gustavgaston/ggsmdriver/README.md

# GGSMDriver

A small, reusable stepper driver module: STM32G0B1 + TMC2209, one 9–24 V supply
and a 4-wire motor on one row of screw terminals along one edge, and USB-C for serial
and firmware upload. The board is 4 layers, 55×45 mm, with every
part on top, for JLCPCB assembly.

## Layout

| Path | What |
|---|---|
| `requirements.md` | Circuit spec, pin map, parts with LCSC numbers, confirmed decisions |
| `PLAN.md` | Milestones |
| `HANDOFF.md` | Current state and how to regenerate everything (start here when resuming) |
| `hardware/ggsmdriver.py` | The design as Python: parts, pin→net map, PCB placement |
| `hardware/ggsmdriver.kicad_sym` | Custom TMC2209 symbol |
| `kicad/` | Generated KiCad project (schematic, PCB, PDF) and `reports/` |
| `kicad/fab/` | JLCPCB gerbers zip, BOM and placement (CPL) files |
| `firmware/` | STM32 HAL firmware: ggstepper core + Automato over USB serial (see its README) |

The KiCad files are generated by [autopcb](https://github.com/gustavgaston/autopcb)
from `hardware/ggsmdriver.py`; hand edits in KiCad are lost on regeneration.
They are KiCad 7 format and open in KiCad 10.

## Status

- Schematic: done (ERC clean in KiCad 10).
- PCB: generated and fully routed as a practice run; routing, placement and
  silkscreen to be reworked later.
- Fab files: generated.
- Firmware: ported and building; untested on hardware.
