gustavgaston/ggsmdriver/requirements.md

# GGSMDriver — requirements and circuit spec

Milestone 1, 2026-10-16. All confirmed by Gustav.

## Confirmed decisions

| Topic | Decision |
|---|---|
| MCU | STM32G0B1CBT6 (LQFP48) |
| Supply | 9–24 V DC on a 2-pole terminal next to the motor terminal (barrel jack dropped 2026-10-19). No protection. |
| Supply use | Feeds TMC2209 VM directly; a buck makes 5 V, an LDO makes 3.3 V for MCU and TMC2209 VCC_IO. |
| USB | USB-C, USB 2.0 FS device, firmware upload via ROM DFU (BOOT button). USB alone powers the MCU when the supply is off. |
| Driver | TMC2209, Adafruit breakout as the base circuit. STEP/DIR/EN hardwired to the MCU, UART for setup, DIAG to the MCU. |
| Motor | 4-pole terminal for a 4-wire bipolar motor. |
| Expansion | Header with 2 × GPIO/ADC and 2 × timer pins for a quadrature encoder. |
| Build | JLCPCB assembly. |

## Blocks

### Power
- `VIN` (9–24 V) = 2-pole terminal → TMC2209 VS, buck input.
- Buck TPS54202 (4.5–28 V in, 500 kHz) → `+5V`, using TI's 5 V reference
  design: 15 µH, 2 × 22 µF 25 V out, 10 µF 50 V + 0.1 µF in, 0.1 µF BOOT,
  FB 100 k / 13 k (5.18 V) with 100 pF across the top resistor (was 75 pF, Extended), EN left to its pull-up.
- USB VBUS → Schottky → `+5V` (diode-OR as on BTT EBB36: when VIN is
  present the buck wins and the diode stops back-feeding the PC).
- `+5V` → XC6206P332 LDO (200 mA) → `+3V3` (MCU, TMC2209 VCC_IO, LEDs, header).
- Power LED on `+3V3`.

### MCU (STM32G0B1CBT6)
- VDD/VDDA, VBAT, VREF+ → `+3V3`; 100 nF per pin + 4.7 µF bulk.
- No crystal: USB runs from HSI48 with CRS.
- NRST: 100 nF to GND + RESET button to GND.
- PA14-BOOT0: BOOT button to `+3V3`, 10 k pull-down (shares SWCLK).
- SWD on J6, an STDC14 connector for the STLINK-V3MINIE flat cable (2026-10-21; replaced the test pads).
- Pins 30/31 tied to GND / `+3V3`: they are PC6/PC7 on CBT6 and
  VSS/VDDIO2 on CBT6N, so either part fits the same board.
- UCPD dead-battery pins 29/32 left open (as EBB36).

### USB-C
- 16-pin receptacle; CC1 and CC2 each 5.1 k to GND (so C-to-C cables power it).
- D+/D− to PA12/PA11 (pins 34/33), USBLC6-2SC6 ESD on the data pair.
- Shield to GND through 1 M ∥ 10 nF (as EBB36).

### TMC2209 (Adafruit base)
Copied from the Adafruit breakout:
- Sense resistors BRA/BRB 0.05 Ω (≈2 A max); 1 W 1206 parts instead of
  0.25 W, since 2 A RMS puts 0.2 W in each.
- CPI–CPO 22 nF 50 V; VCP–VS 0.22 µF 50 V.
- VS: 2 × 0.22 µF 50 V + 22 µF 50 V electrolytic.
- 5VOUT 10 µF; VCC_IO 10 µF + 0.22 µF on `+3V3`.
- VREF to GND: current is always set over UART (IRUN/IHOLD, `i_scale_analog` = 0), so no
  trimmer (removed 2026-10-19; was 10 k fed through 33 k from 5VOUT as on Adafruit).
- CLK to GND (internal clock).
- SPREAD via solder jumper (open = StealthChop; UART overrides anyway).
- STEP/DIR LEDs as on Adafruit.

Deviations (confirmed 2026-10-16):
- ENN pulled **up** 10 k to `+3V3`, so the motor stays off while the MCU
  boots or sits in DFU. Adafruit pulls it down (driver on at power-up).
- MS1_AD0, MS2_AD1 to GND: UART address 0 (ggstepper uses 0).
- STDBY to GND (as EBB36).
- UART per datasheet two-pin scheme: MCU TX → 1 k → PDN_UART, MCU RX direct.
- INDEX left unconnected.

### Connectors
- J3 one 6-pole 2.54 mm screw terminal (Cixi Kefa KF128-2.54-6P, as Adafruit's 2.54 mm
  6-pole), on the right edge. Top to bottom: B2, B1, A1, A2, GND, VIN (pin 6 to 1).
- Motor order matches the TMC2209 pins, so the motor tracks don't cross; coil A polarity
  is swapped, which only flips the direction.
- J4 1×7 2.54 mm header: +5V, +3V3, GND, IO1, IO2, ENC_A, ENC_B.
- J5 USB-C.

## Pin map (STM32G0B1CBT6)

| Pin | Port | Net | Why this pin |
|---|---|---|---|
| 11 | PA0 | ENC_A | TIM2_CH1 (32-bit timer, encoder mode) |
| 12 | PA1 | ENC_B | TIM2_CH2 |
| 13 | PA2 | TMC_TX | USART2_TX (→ 1 k → PDN_UART) |
| 14 | PA3 | TMC_RX | USART2_RX |
| 15 | PA4 | IO1 | ADC1_IN4 (also DAC1_OUT1) |
| 16 | PA5 | IO2 | ADC1_IN5 (also DAC1_OUT2) |
| 17 | PA6 | TMC_STEP | TIM3_CH1: hardware step pulses |
| 18 | PA7 | TMC_DIR | GPIO |
| 19 | PB0 | TMC_EN | GPIO (ENN, active low) |
| 20 | PB1 | TMC_DIAG | GPIO/EXTI1 |
| 21 | PB2 | LED_STATUS | GPIO |
| 45 | PB6 | VCP_TX | USART1_TX → J6 pin 14 (STLINK virtual COM) |
| 46 | PB7 | VCP_RX | USART1_RX ← J6 pin 13 |
| 33 | PA11 | USB_DM | USB |
| 34 | PA12 | USB_DP | USB |
| 35 | PA13 | SWDIO | J6 pin 4 |
| 36 | PA14-BOOT0 | BOOT0/SWCLK | BOOT button, J6 pin 6 |
| 10 | PF2-NRST | NRST | RESET button, J6 pin 12 |

Pin functions checked against ST's STM32_open_pin_data
(`mcu/STM32G0B1C(B-C-E)Tx.xml`). USB on pins 33/34 matches BTT EBB36 V1.2.

## Parts (JLCPCB / LCSC)

Checked on jlcpcb.com / lcsc.com pages on 2026-10-16. Generic resistors and
capacitors get picked from JLC Basic parts in milestone 2.

| Ref | Part | LCSC | JLC type | Note |
|---|---|---|---|---|
| U1 | STM32G0B1CBT6 | C2847904 | Extended | |
| U2 | TMC2209-LA-T (tape & reel of -LA; -LA C465949 out of stock) | C2150710 | Extended | |
| U3 | TPS54202DDCR | C191884 | Extended | |
| L1 | 15 µH 2.5 A SMNR6045-150MT | C467142 | Extended | 6×6 mm |
| U4 | XC6206P332MR-G | C5446 | Basic | |
| D1 | SS14 (VBUS OR-diode) | C2480 | Basic | |
| U5 | USBLC6-2SC6 | C7519 | Extended | |
| J5 | USB-C HRO TYPE-C-31-M-12 | C165948 | Extended | |
| J3 | KF128-2.54-6P terminal, 8 A, 18-26 AWG (KiCad footprint Phoenix MPT-0,5-6-2.54) | C474924 | Extended | THT |
| J4 | 1×7 2.54 mm header | none | hand-soldered | not in JLC BOM |
| R_sense ×2 | 0.05 Ω 1 W 1206 RALEC LR1206-21R050F4 (CUM1206 out of stock) | C154645 | Extended | |
| LEDs ×5 | 0603 red KT-0603R (PWR, STATUS, STEP, DIR high, DIR low) | C2286 | Basic | |
| C_bulk | 22 µF 50 V electrolytic Lelon VES220M1HTR-0605 | C176676 | Extended | |
| SW1, SW2 | TS-1187A-B-A-B tactile | C318884 | Basic | BOOT, RESET |

## Confirmed 2026-10-16 (milestone 1 review)

- ENN pulled up (driver off until the MCU enables it).
- DC-005 jack with 2.0 mm pin is fine.
- 3.5 mm terminals are fine.
- Header keeps both +5V and +3V3 (encoder voltage varies).
- Board about 50×40 mm with 4 M3 holes.

## Confirmed 2026-10-16 (milestone 2 review)

- Gustav ran ERC in KiCad 10: no errors.
- Keep the DC-005 jack despite its 12 V / 1 A datasheet rating.
- Buck feedback 100 k / 13 k (JLC Basic) → 5.18 V. Inductor C467142 15 µH 2.5 A.

## Confirmed 2026-10-16 (milestone 3)

- PCB: 4 layers, 55×45 mm (F.Cu / In1.Cu GND plane / In2.Cu / B.Cu), all parts on top.
  50×40 on 2 layers did not fit with single-sided assembly.
- Layout (generated, in review): TMC2209 turned so its motor/sense pins face the motor
  terminal J3 on the right; jack and supply terminal on the left; USB-C bottom;
  expansion header top. Motor and sense nets 0.8 mm,
  power nets 0.5 mm, signals 0.2 mm. 3×3 vias under the TMC2209 pad into the GND plane.

## Confirmed 2026-10-19 (TMC2209 area rework)

- Trimmer RV1 and its 33 k feed removed; VREF to GND (current set over UART only).
- TMC2209 area laid out by hand after the Adafruit breakout: short wide (1 mm) motor tracks
  straight to J3 right next to the chip, sense resistors and VS vias at the BRA/BRB and VS
  pins, VS caps about 3 mm away joined through the In2.Cu VIN plane.
- In2.Cu is now a VIN plane (In1.Cu stays GND).
- J3 pin order is A2, A1, B1, B2.
- Track widths now really apply (motor/sense 0.8-1 mm, power 0.5 mm, +3V3 and signals
  0.2 mm); before this every track was routed at 0.2 mm.

## Confirmed 2026-10-19 (round 2, Gustav)

- Barrel jack J1 removed; power only via the 2-pole terminal J2, moved next to the motor
  terminal on the right edge.
- Stocked replacements: TMC2209-LA-T (C2150710), sense resistors RALEC LR1206-21R050F4
  (C154645), LEDs red C2286 (Basic) and green C12624 (Extended). No in-stock Basic green,
  blue or yellow 0603 LED found; white is Basic but too dim on 3.3 V through 1-20 k.
- Fixed: TMC2209 SPREAD pin had been left unconnected by the 2026-10-19 rework edit.

## 2026-10-19 (round 3: stock)

- C20 22 µF 50 V: Lelon VES220M1HTR-0605 (C176676, 6.3×5.3 mm) replaces 50CE22FS C242075.
- Motor terminal split into two KF350-3.5-2P (J6 coil B, J3 coil A) since the 4P is out of
  stock; coil B tracks, R10 and C19 moved up to make room.

## Confirmed 2026-10-20 (Gustav)

- Power + motor on one standard 0.1"/2.54 mm 6-pole terminal (KF128-2.54-6P, C474924, in
  stock at JLC; fallback if not: Phoenix MPT 0,5/6-2,54, Mouser 651-1725698, hand-soldered,
  same footprint but only 26-20 AWG). Replaces the 2+2+2 KF350 3.5 mm blocks.

## 2026-10-20 (track review, Gustav: "make the fixes")

- Buck switch node hand-laid: U3 turned 180° so SW faces L1; 0.8 mm SW track about 2.7 mm
  long; VIN and GND pins get their own plane vias.
- USB D+/D- hand-laid as a pair on F.Cu over the In1 GND plane: 0.25 mm tracks, 0.15 mm gap
  (about 90 ohm differential on JLC's standard 4-layer stackup by formula, not verified in
  JLC's calculator), through the USBLC6 ESD pads (flow-through, U5 beside U1). The 0.15 mm
  gap is allowed only between D+ and D- (`kicad/ggsmdriver.kicad_dru`). USB is full speed only.
- U1 pins 30 (GND) and 31 (+3V3) sit inside the pair and fan out to vias under the MCU body.

## 2026-10-20 (Extended-part pass, Gustav: every Extended part costs $3)

- All LEDs red C2286 (Basic). J4 header has no LCSC number, so it stays out of the JLC
  BOM/CPL and is hand-soldered.
- C16 22 nF -> Samsung CL10B223KB8NNNC C21122 (Basic, same spec).
- C17, C18, C19, C23 220 nF -> 100 nF 50 V C14663 (Basic). 220 nF came from Adafruit's
  breakout (0.22 uF/50V on VCP, VS x2, VDD). The TMC2209 datasheet (rev 1.08, 2.2) gives
  100 nF for VCP; it names no value for the VS ceramics or VCC_IO, and Trinamic's own
  TMC2209-BOB uses 100 nF 50 V parts.
- C4 buck feed-forward briefly 100 pF; back to 75 pF C1681 (Gustav: keep the TI value,
  accept the $3). 75 pF and the whole buck
  (100 k/13.3 k, 15 uH, 2x22 uF) come from TI's TPS54202 EVM guide. With 100 k/13 k the
  Cff zero/pole move from 21/184 kHz to 16/138 kHz: phase boost stays within about 3 deg
  over 30-80 kHz, loop gain near crossover rises up to about 2 dB (crossover up about 25%).
  Calculated, not simulated or measured.
- LEDs in one column on the left (Gustav: free space there, no signals around the TMC2209):
  resistor outboard, LED, then a PWR/STAT/STEP/DIR+/DIR- silk label; their designators
  are hidden. Each pair is turned so the shared pads face and joined by a hand track.
- Silkscreen: pcbgen `tidy_silk()` sets all designators to 0.8 mm and moves each clear of
  pads, silk and other designators (C12 placed by hand); mounting-hole refs hidden.
  DRC is clean, silkscreen included.
- Still Extended: U1, U2, U3, U5, L1, J3, J5, R9/R10, C20 (no Basic equivalent) and C4 (kept).

## Revision 1: locked 2026-10-21 (Gustav)

Board, schematic and fab files at git tag `rev1` are frozen until the JLCPCB order is
placed. Change requests from now on go into a rev 2 list, not into the design.
Before ordering: check LED polarity and part rotations in JLC's placement preview, and
hand-solder J4 (header) and J6 (Samtec FTSH-107-01-L-DV-K).

## 2026-10-21 (debug connector, Gustav)

- No debugging over USB: DFU only flashes. Debug stays SWD through the STLINK-V3MINIE.
  The G0 is a Cortex-M0+, so there is no SWO trace; breakpoints, stepping and memory
  view work.
- J6: STDC14 (2x7, 1.27 mm), Samtec FTSH-107-01-L-DV-K (keyed shroud for the FFSD flat
  cable that ships with the MINIE; pinout from ST UM2910). Footprint KiCad
  PinHeader_2x07_P1.27mm_Vertical_SMD. No LCSC number: hand-soldered.
  Pins: 3 +3V3 (probe senses only, it does not power the board), 4 SWDIO, 6 SWCLK,
  5/7/11 GND (11 is GNDDetect), 12 NRST, 13 VCP_RX -> PB7, 14 VCP_TX <- PB6;
  1, 2, 8, 9, 10 not connected.
- The five SWD test pads were removed (same signals on J6). The MCU decoupling caps
  are pinned in their column next to U1.

## Confirmed 2026-10-17 (firmware)

- Framework: STM32 HAL, as an STM32CubeIDE project in `firmware/` (plus a Makefile
  for command-line builds).
- Scope of the first port: ggstepper core only (driver UART setup, StallGuard/DIAG
  homing, normalized moves, status, debug reports). Sequences and the
  calibration/configurator commands come later.
- Host protocol: the Automato bridge (`automato.serial.v2`) over USB CDC serial, so
  the module drops in where the Uno + ggstepper was used.
