gustavgaston/ggsmdriver/kicad/reports/connectivity.txt

+3V3: C10.1 C11.1 C12.1 C13.1 C14.1 C22.1 C23.1 J4.2 J6.3 JP1.2 R12.2 R16.1 R6.1 SW1.1 U1.31 U1.4 U1.5 U1.6 U2.15 U4.2
+5V: C4.1 C5.1 C6.1 C9.1 D1.1 J4.1 L1.2 R1.1 U4.3
BOOT0_SWCLK: J6.6 R7.1 SW1.2 U1.36
BUCK_BST: C3.1 U3.6
BUCK_FB: C4.2 R1.2 R2.1 U3.4
BUCK_SW: C3.2 L1.1 U3.2
ENC_A: J4.6 U1.11
ENC_B: J4.7 U1.12
GND: C1.2 C10.2 C11.2 C12.2 C13.2 C14.2 C15.2 C18.2 C19.2 C2.2 C20.2 C21.2 C22.2 C23.2 C5.2 C6.2 C7.2 C8.2 C9.2 D2.1 D3.1 D4.1 J3.2 J4.3 J5.A1 J5.A12 J5.B1 J5.B12 J6.11 J6.5 J6.7 R10.2 R15.2 R2.2 R3.2 R4.2 R5.2 R7.2 R9.2 SW2.2 U1.30 U1.7 U2.10 U2.13 U2.17 U2.18 U2.20 U2.25 U2.29 U2.3 U2.9 U3.1 U4.1 U5.2
IO1: J4.4 U1.15
IO2: J4.5 U1.16
LED_DIRH: D5.1 R15.1
LED_DIRL: D6.2 R16.2
LED_PWR: D2.2 R6.2
LED_STAT: D3.2 R8.2
LED_STAT_R: R8.1 U1.21
LED_STEP: D4.2 R14.2
MOT_A1: J3.4 U2.24
MOT_A2: J3.3 U2.21
MOT_B1: J3.5 U2.26
MOT_B2: J3.6 U2.1
NRST: C15.1 J6.12 SW2.1 U1.10
SWDIO: J6.4 U1.35
TMC_5V: C21.1 U2.8
TMC_BRA: R9.1 U2.23
TMC_BRB: R10.1 U2.27
TMC_CPI: C16.1 U2.5
TMC_CPO: C16.2 U2.4
TMC_DIAG: U1.20 U2.11
TMC_DIR: D5.2 D6.1 U1.18 U2.19
TMC_EN: R12.1 U1.19 U2.2
TMC_SPREAD: JP1.1 U2.7
TMC_STEP: R14.1 U1.17 U2.16
TMC_TX: R13.1 U1.13
TMC_UART: R13.2 U1.14 U2.14
TMC_VCP: C17.1 U2.6
USB_CC1: J5.A5 R3.1
USB_CC2: J5.B5 R4.1
USB_DM: J5.A7 J5.B7 U1.33 U5.1 U5.6
USB_DP: J5.A6 J5.B6 U1.34 U5.3 U5.4
USB_SHIELD: C7.1 J5.S1 R5.1
VBUS: C8.1 D1.2 J5.A4 J5.A9 J5.B4 J5.B9 U5.5
VCP_RX: J6.13 U1.46
VCP_TX: J6.14 U1.45
VIN: C1.1 C17.2 C18.1 C19.1 C2.1 C20.1 J3.1 U2.22 U2.28 U3.3
unconnected-(J5-SBU1-PadA8): J5.A8
unconnected-(J5-SBU2-PadB8): J5.B8
unconnected-(J6-Pin_1-Pad1): J6.1
unconnected-(J6-Pin_10-Pad10): J6.10
unconnected-(J6-Pin_2-Pad2): J6.2
unconnected-(J6-Pin_8-Pad8): J6.8
unconnected-(J6-Pin_9-Pad9): J6.9
unconnected-(U1-PA10{slash}UCPD1_DBCC2-Pad32): U1.32
unconnected-(U1-PA15-Pad37): U1.37
unconnected-(U1-PA8-Pad28): U1.28
unconnected-(U1-PA9{slash}UCPD1_DBCC1-Pad29): U1.29
unconnected-(U1-PB10-Pad22): U1.22
unconnected-(U1-PB11-Pad23): U1.23
unconnected-(U1-PB12-Pad24): U1.24
unconnected-(U1-PB13-Pad25): U1.25
unconnected-(U1-PB14-Pad26): U1.26
unconnected-(U1-PB15-Pad27): U1.27
unconnected-(U1-PB3-Pad42): U1.42
unconnected-(U1-PB4-Pad43): U1.43
unconnected-(U1-PB5-Pad44): U1.44
unconnected-(U1-PB8-Pad47): U1.47
unconnected-(U1-PB9-Pad48): U1.48
unconnected-(U1-PC13-Pad1): U1.1
unconnected-(U1-PC14-Pad2): U1.2
unconnected-(U1-PC15-Pad3): U1.3
unconnected-(U1-PD0-Pad38): U1.38
unconnected-(U1-PD1-Pad39): U1.39
unconnected-(U1-PD2-Pad40): U1.40
unconnected-(U1-PD3-Pad41): U1.41
unconnected-(U1-PF0-Pad8): U1.8
unconnected-(U1-PF1-Pad9): U1.9
unconnected-(U2-INDEX-Pad12): U2.12
unconnected-(U3-EN-Pad5): U3.5

0 mismatches
