gustavgaston/ggsmdriver/kicad/reports/pcb-summary.txt

parts: 61  nets: 45
placement: 0 problems
routing: 393 segments, 36 vias, 0 unrouted
stitched GND: 1 vias, 0 unrouted
stitched VIN: 0 vias, 0 unrouted
DRC: clean
unconnected items: 0
preview: reports/preview.svg
runtime: 67 s
