gustavgaston/ggsmdriver/kicad/reports/preview-bottom.png

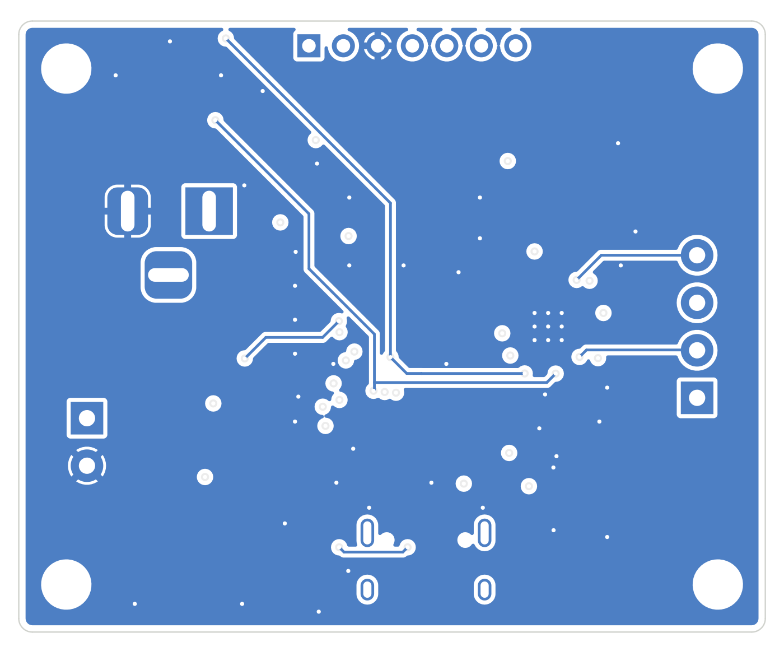
kicad/reports/preview-bottom.png
