gustavgaston/ggsmdriver/kicad/reports/preview-in2.png

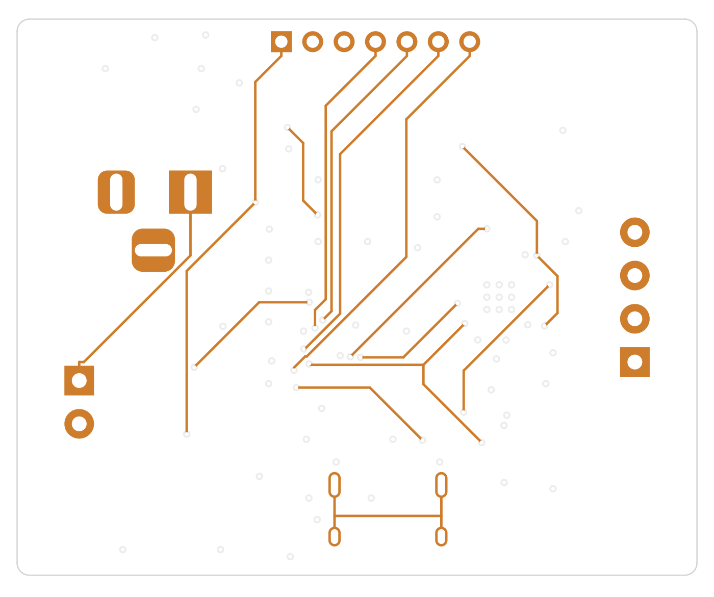
kicad/reports/preview-in2.png
