gustavgaston/ggsmdriver/kicad/reports/preview-top.png

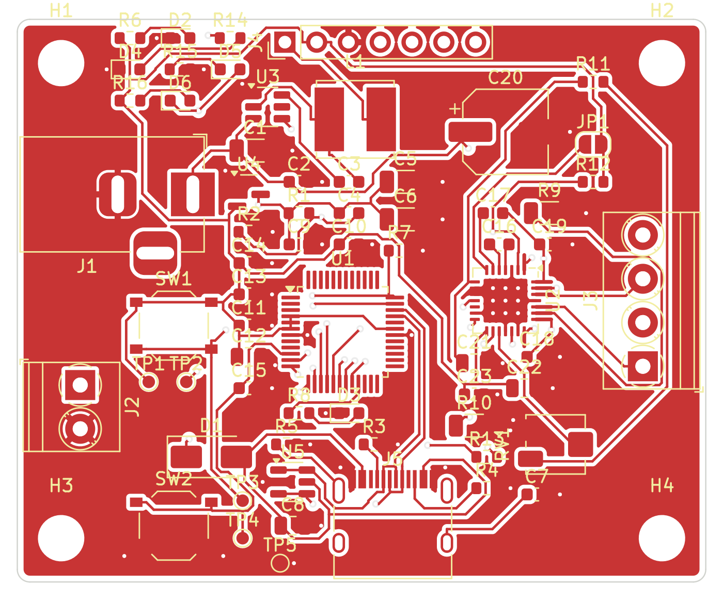
kicad/reports/preview-top.png
