gustavgaston/ggsmdriver/kicad/fab/ggsmdriver-bom.csv

Comment | Designator | Footprint | LCSC Part #
10uF 50V | C1 | C_1206_3216Metric | C13585
22nF 50V | C16 | C_0603_1608Metric | C21122
100nF 50V | C2,C17,C18,C19 | C_0603_1608Metric | C14663
22uF 50V | C20 | CP_Elec_6.3x5.4 | C176676
10uF | C21,C22 | C_0805_2012Metric | C15850
100nF | C3,C11,C13,C14,C15,C23 | C_0603_1608Metric | C14663
75pF | C4 | C_0603_1608Metric | C1681
22uF 25V | C5,C6 | C_1206_3216Metric | C12891
10nF | C7 | C_0603_1608Metric | C57112
4.7uF | C8,C12 | C_0805_2012Metric | C1779
1uF | C9,C10 | C_0603_1608Metric | C15849
SS14 | D1 | D_SMA | C2480
PWR red | D2 | LED_0603_1608Metric | C2286
STATUS red | D3 | LED_0603_1608Metric | C2286
STEP red | D4 | LED_0603_1608Metric | C2286
DIR+ red | D5 | LED_0603_1608Metric | C2286
DIR- red | D6 | LED_0603_1608Metric | C2286
VIN GND A2 A1 B1 B2 | J3 | TerminalBlock_Phoenix_MPT-0,5-6-2.54_1x06_P2.54mm_Horizontal | C474924
USB-C | J5 | USB_C_Receptacle_HRO_TYPE-C-31-M-12 | C165948
15uH | L1 | L_Bourns_SRN6045TA | C467142
100k | R1 | R_0603_1608Metric | C25803
20k | R14,R15,R16 | R_0603_1608Metric | C4184
13k | R2 | R_0603_1608Metric | C22797
5.1k | R3,R4 | R_0603_1608Metric | C23186
1M | R5 | R_0603_1608Metric | C22935
1k | R6,R8,R13 | R_0603_1608Metric | C21190
10k | R7,R12 | R_0603_1608Metric | C25804
0.05R 1W | R9,R10 | R_1206_3216Metric | C154645
BOOT | SW1 | SW_Push_1P1T_XKB_TS-1187A | C318884
RESET | SW2 | SW_Push_1P1T_XKB_TS-1187A | C318884
STM32G0B1CBT6 | U1 | LQFP-48_7x7mm_P0.5mm | C2847904
TMC2209-LA-T | U2 | QFN-28-1EP_5x5mm_P0.5mm_EP3.35x3.35mm | C2150710
TPS54202DDCR | U3 | TSOT-23-6 | C191884
XC6206P332MR | U4 | SOT-23 | C5446
USBLC6-2SC6 | U5 | SOT-23-6 | C7519
