gustavgaston/ggsmdriver/kicad/fab/case/ggsmdriver-case.step

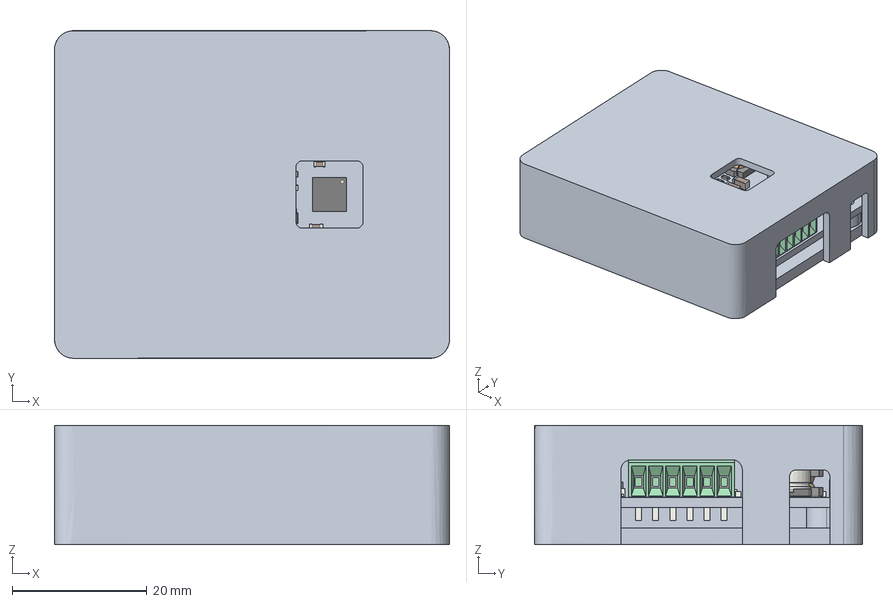
[picture p4: CAD file, 2026-10-23]
kicad/fab/case/ggsmdriver-case.step
58.6 x 48.6 x 17.7 mm
