gustavgaston/ggsmdriver/kicad/fab/case/ggsmdriver-case-bottom.step

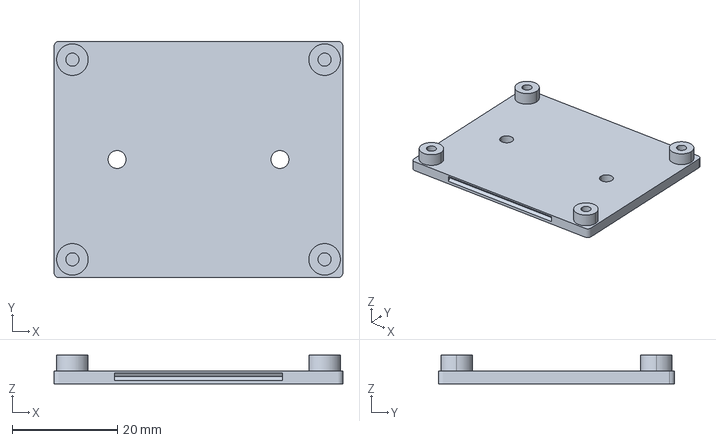
[picture p5: CAD file, 2026-10-23]
kicad/fab/case/ggsmdriver-case-bottom.step
55.0 x 45.0 x 5.50 mm
