gustavgaston/ggsmdriver/kicad/fab/case/ggsmdriver-case-top.step

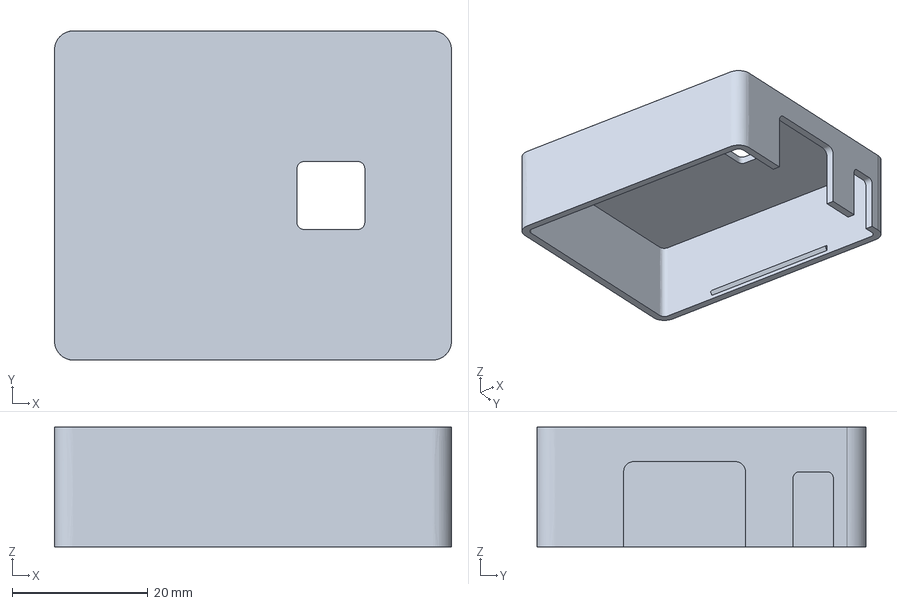
[picture p6: CAD file, 2026-10-23]
kicad/fab/case/ggsmdriver-case-top.step
58.6 x 48.6 x 17.7 mm
