gustavgaston/ggsmdriver/(list of files, cad)

Other CAD files:
kicad/fab/case/ggsmdriver-case-bottom-print.stl
kicad/fab/case/ggsmdriver-case-top-print.stl
kicad/fab/case/ggsmdriver_case.3dm
