gustavgaston/ggsmdriver/kicad/ggsmdriver.pdf

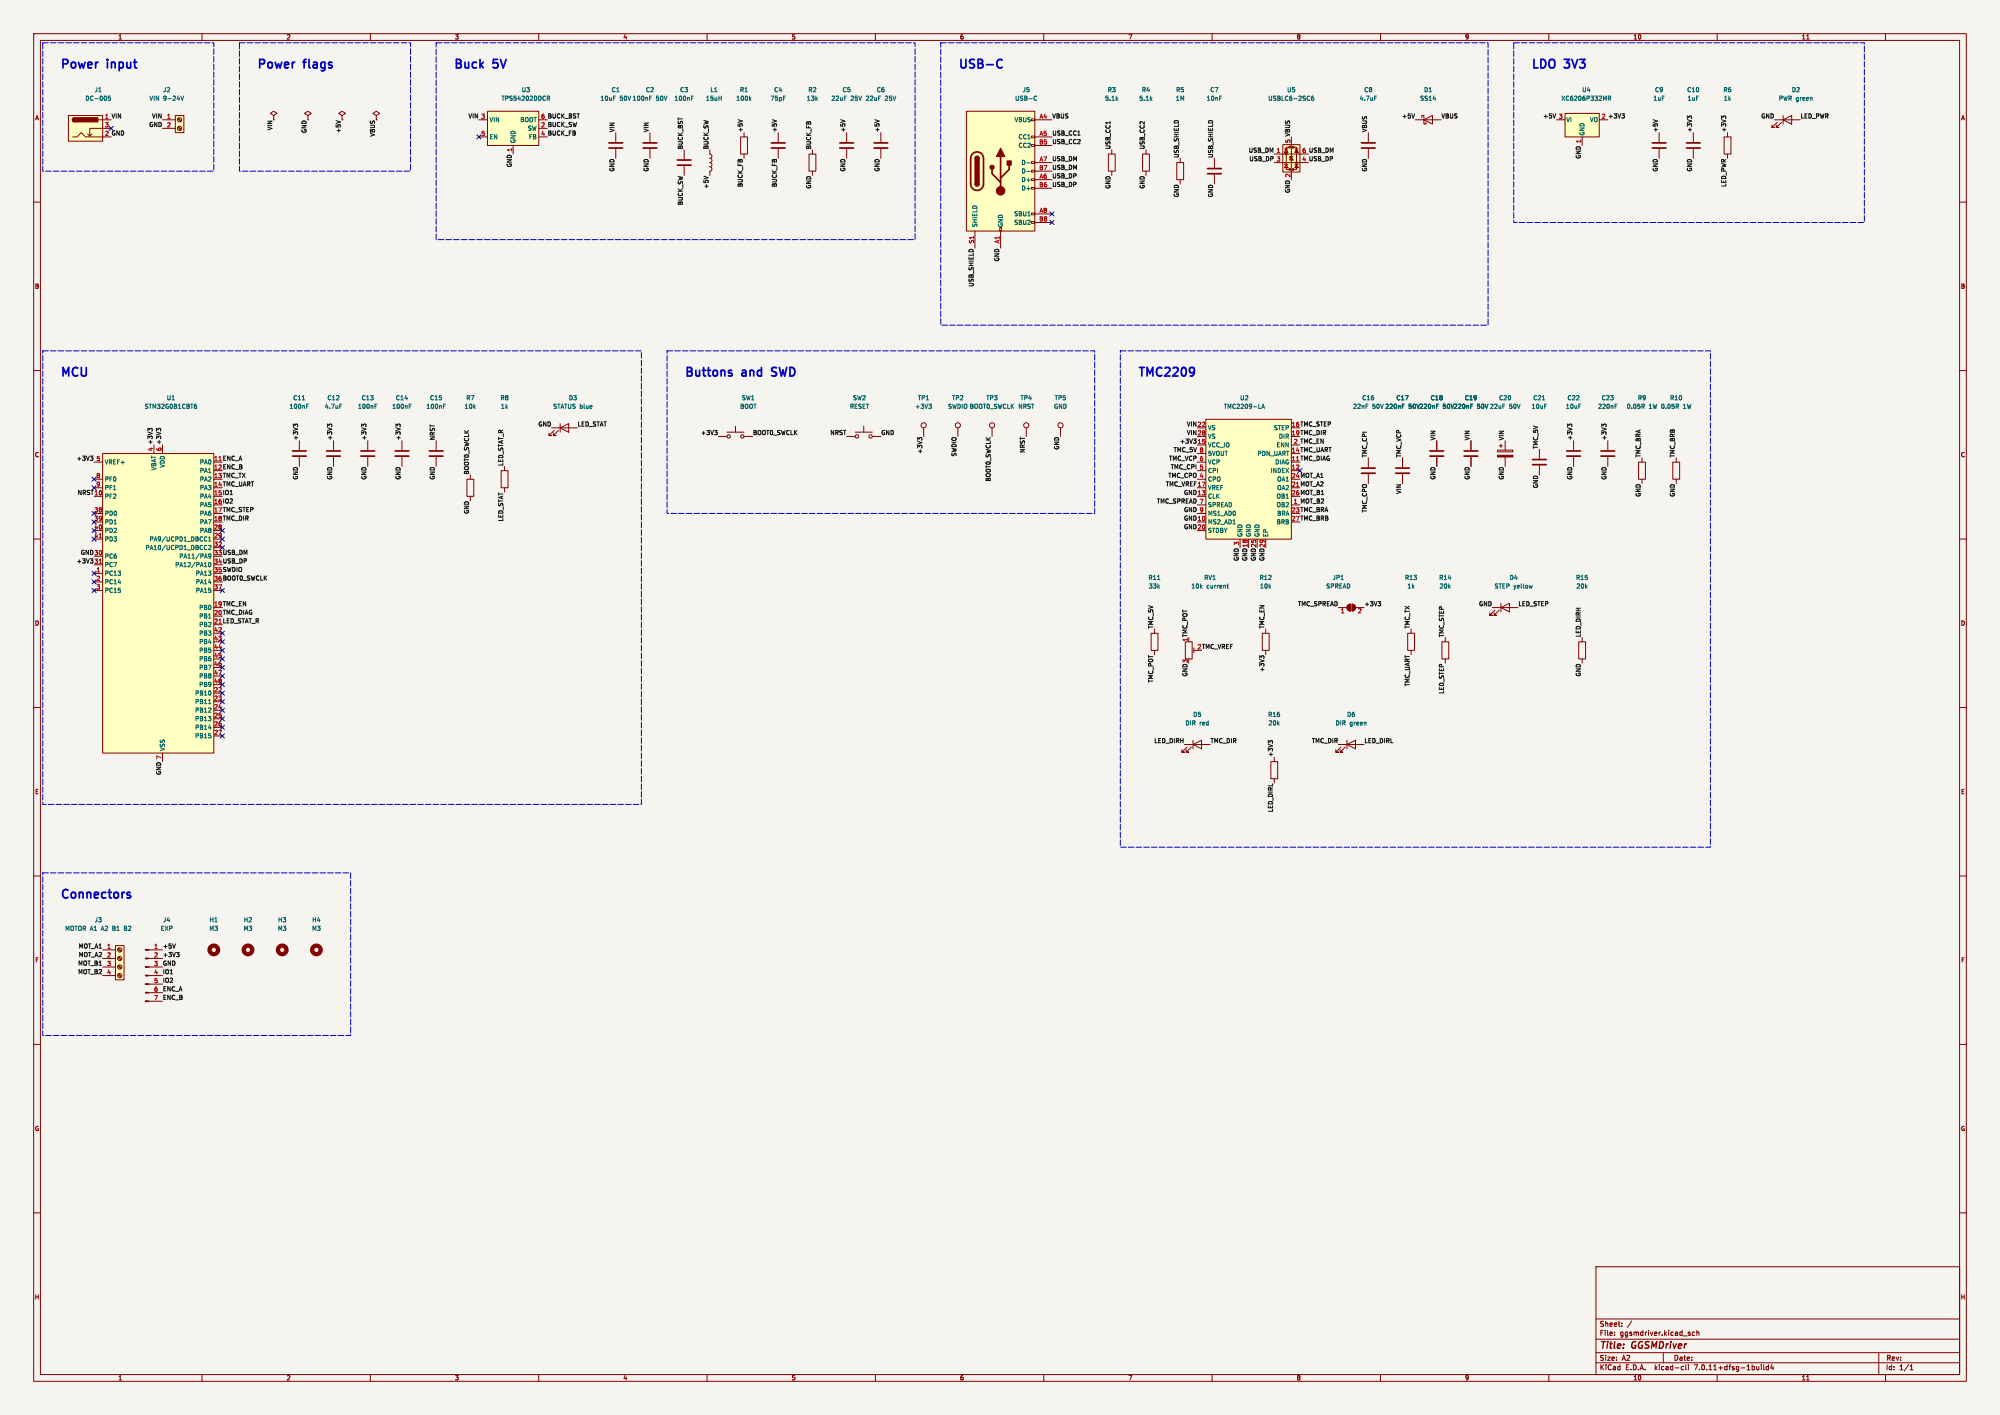
[picture p7: page 1]

1 SW 2 VIN 3 FB 4 EN 5 BOOT 6 U3 TPS54202DDCR
