gustavgaston/ggsmdriver/kicad/ggsmdriver.kicad_pcb

## KiCad design kicad/ggsmdriver.kicad_pcb (2026-10-21)

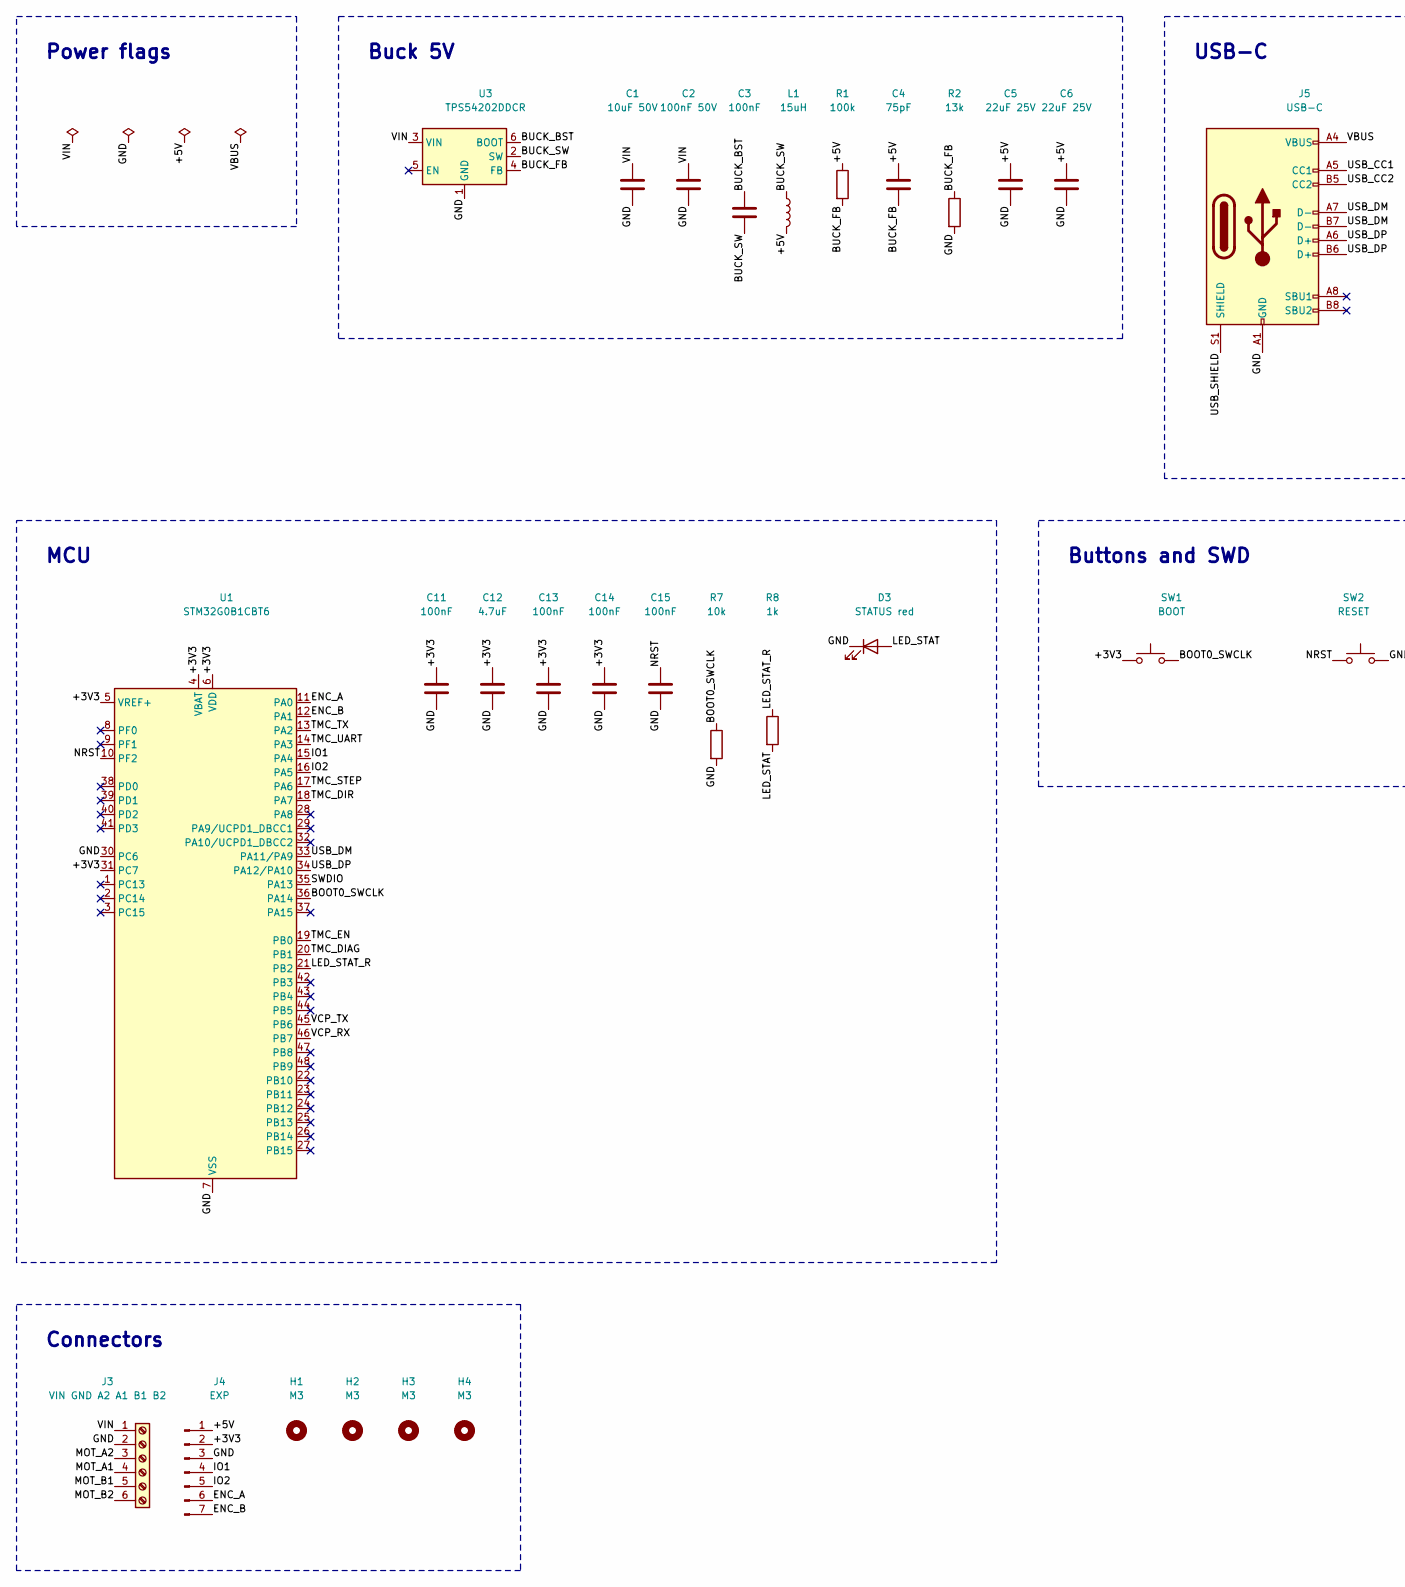
[picture p8: schematic ggsmdriver.kicad_sch, part in row 1, column 1]

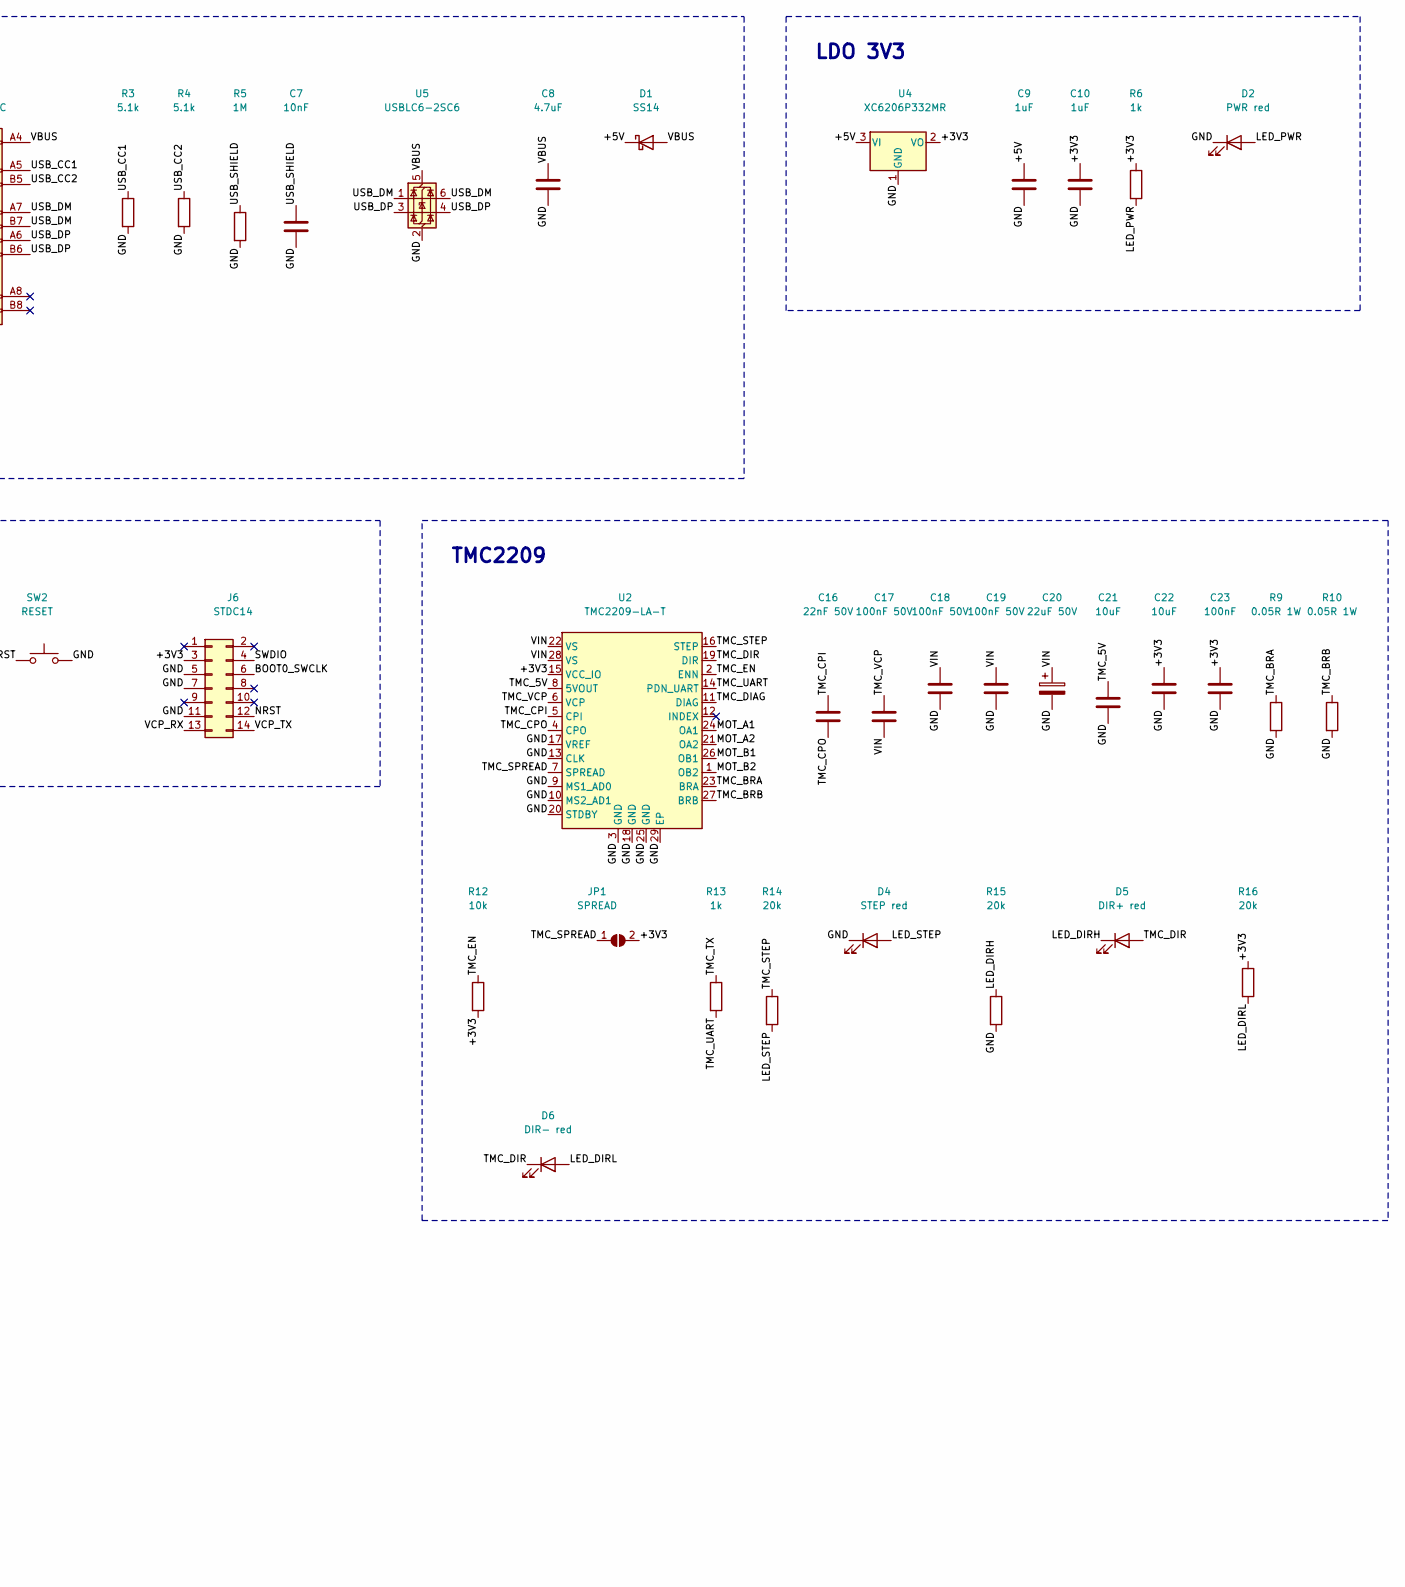
[picture p9: schematic ggsmdriver.kicad_sch, part in row 1, column 2]

Parts:
C1: 10uF 50V; C_1206_3216Metric; LCSC C13585
C2, C17, C18, C19: 100nF 50V; C_0603_1608Metric; LCSC C14663
C3, C11, C13, C14, C15, C23: 100nF; C_0603_1608Metric; LCSC C14663
C4: 75pF; C_0603_1608Metric; LCSC C1681
C5, C6: 22uF 25V; C_1206_3216Metric; LCSC C12891
C7: 10nF; C_0603_1608Metric; LCSC C57112
C8, C12: 4.7uF; C_0805_2012Metric; LCSC C1779
C9, C10: 1uF; C_0603_1608Metric; LCSC C15849
C16: 22nF 50V; C_0603_1608Metric; LCSC C21122
C20: 22uF 50V; CP_Elec_6.3x5.4; LCSC C176676
C21, C22: 10uF; C_0805_2012Metric; LCSC C15850
D1: SS14; D_SMA; LCSC C2480
D2: PWR red; LED_0603_1608Metric; LCSC C2286
D3: STATUS red; LED_0603_1608Metric; LCSC C2286
D4: STEP red; LED_0603_1608Metric; LCSC C2286
D5: DIR+ red; LED_0603_1608Metric; LCSC C2286
D6: DIR- red; LED_0603_1608Metric; LCSC C2286
H1, H2, H3, H4: M3; MountingHole_3.2mm_M3
J3: VIN GND A2 A1 B1 B2; TerminalBlock_Phoenix_MPT-0,5-6-2.54_1x06_P2.54mm_Horizontal; LCSC C474924
J4: EXP; PinHeader_1x07_P2.54mm_Vertical
J5: USB-C; USB_C_Receptacle_HRO_TYPE-C-31-M-12; LCSC C165948
J6: STDC14; PinHeader_2x07_P1.27mm_Vertical_SMD
JP1: SPREAD; SolderJumper-2_P1.3mm_Open_RoundedPad1.0x1.5mm
L1: 15uH; L_Bourns_SRN6045TA; LCSC C467142
R1: 100k; R_0603_1608Metric; LCSC C25803
R2: 13k; R_0603_1608Metric; LCSC C22797
R3, R4: 5.1k; R_0603_1608Metric; LCSC C23186
R5: 1M; R_0603_1608Metric; LCSC C22935
R6, R8, R13: 1k; R_0603_1608Metric; LCSC C21190
R7, R12: 10k; R_0603_1608Metric; LCSC C25804
R9, R10: 0.05R 1W; R_1206_3216Metric; LCSC C154645
R14, R15, R16: 20k; R_0603_1608Metric; LCSC C4184
SW1: BOOT; SW_Push_1P1T_XKB_TS-1187A; LCSC C318884
SW2: RESET; SW_Push_1P1T_XKB_TS-1187A; LCSC C318884
U1: STM32G0B1CBT6; LQFP-48_7x7mm_P0.5mm; LCSC C2847904
U2: TMC2209-LA-T; QFN-28-1EP_5x5mm_P0.5mm_EP3.35x3.35mm; LCSC C2150710
U3: TPS54202DDCR; TSOT-23-6; LCSC C191884
U4: XC6206P332MR; SOT-23; LCSC C5446
U5: USBLC6-2SC6; SOT-23-6; LCSC C7519

Connections:
+3V3: C10.1, C11.1, C12.1, C13.1, C14.1, C22.1, C23.1, J4.2, J6.3, JP1.2 (B), R6.1, R12.2, R16.1, SW1.1, U1.4 (VBAT), U1.5 (VREF+), U1.6 (VDD), U1.31 (PC7), U2.15 (VCC_IO), U4.2 (VO)
+5V: C4.1, C5.1, C6.1, C9.1, D1.1 (K), J4.1, L1.2, R1.1, U4.3 (VI)
BOOT0_SWCLK: J6.6, R7.1, SW1.2, U1.36 (PA14)
BUCK_BST: C3.1, U3.6 (BOOT)
BUCK_FB: C4.2, R1.2, R2.1, U3.4 (FB)
BUCK_SW: C3.2, L1.1, U3.2 (SW)
ENC_A: J4.6, U1.11 (PA0)
ENC_B: J4.7, U1.12 (PA1)
GND: C1.2, C2.2, C5.2, C6.2, C7.2, C8.2, C9.2, C10.2, C11.2, C12.2, C13.2, C14.2, C15.2, C18.2, C19.2, C20.2, C21.2, C22.2, C23.2, D2.1 (K), D3.1 (K), D4.1 (K), J3.2, J4.3, J5.A1 (GND), J5.A12 (GND), J5.B1 (GND), J5.B12 (GND), J6.5, J6.7, J6.11, R2.2, R3.2, R4.2, R5.2, R7.2, R9.2, R10.2, R15.2, SW2.2, U1.7 (VSS), U1.30 (PC6), U2.3 (GND), U2.9 (MS1_AD0), U2.10 (MS2_AD1), U2.13 (CLK), U2.17 (VREF), U2.18 (GND), U2.20 (STDBY), U2.25 (GND), U2.29 (EP), U3.1 (GND), U4.1 (GND), U5.2 (GND)
IO1: J4.4, U1.15 (PA4)
IO2: J4.5, U1.16 (PA5)
LED_DIRH: D5.1 (K), R15.1
LED_DIRL: D6.2 (A), R16.2
LED_PWR: D2.2 (A), R6.2
LED_STAT: D3.2 (A), R8.2
LED_STAT_R: R8.1, U1.21 (PB2)
LED_STEP: D4.2 (A), R14.2
MOT_A1: J3.4, U2.24 (OA1)
MOT_A2: J3.3, U2.21 (OA2)
MOT_B1: J3.5, U2.26 (OB1)
MOT_B2: J3.6, U2.1 (OB2)
NRST: C15.1, J6.12, SW2.1, U1.10 (PF2)
SWDIO: J6.4, U1.35 (PA13)
TMC_5V: C21.1, U2.8 (5VOUT)
TMC_BRA: R9.1, U2.23 (BRA)
TMC_BRB: R10.1, U2.27 (BRB)
TMC_CPI: C16.1, U2.5 (CPI)
TMC_CPO: C16.2, U2.4 (CPO)
TMC_DIAG: U1.20 (PB1), U2.11 (DIAG)
TMC_DIR: D5.2 (A), D6.1 (K), U1.18 (PA7), U2.19 (DIR)
TMC_EN: R12.1, U1.19 (PB0), U2.2 (ENN)
TMC_SPREAD: JP1.1 (A), U2.7 (SPREAD)
TMC_STEP: R14.1, U1.17 (PA6), U2.16 (STEP)
TMC_TX: R13.1, U1.13 (PA2)
TMC_UART: R13.2, U1.14 (PA3), U2.14 (PDN_UART)
TMC_VCP: C17.1, U2.6 (VCP)
USB_CC1: J5.A5 (CC1), R3.1
USB_CC2: J5.B5 (CC2), R4.1
USB_DM: J5.A7 (D-), J5.B7 (D-), U1.33 (PA11/PA9), U5.1 (I/O1), U5.6 (I/O1)
USB_DP: J5.A6 (D+), J5.B6 (D+), U1.34 (PA12/PA10), U5.3 (I/O2), U5.4 (I/O2)
USB_SHIELD: C7.1, J5.S1 (SHIELD), R5.1
VBUS: C8.1, D1.2 (A), J5.A4 (VBUS), J5.A9 (VBUS), J5.B4 (VBUS), J5.B9 (VBUS), U5.5 (VBUS)
VCP_RX: J6.13, U1.46 (PB7)
VCP_TX: J6.14, U1.45 (PB6)
VIN: C1.1, C2.1, C17.2, C18.1, C19.1, C20.1, J3.1, U2.22 (VS), U2.28 (VS), U3.3 (VIN)

Notes on the sheet:
Power flags
Buck 5V
USB-C
LDO 3V3
MCU
Buttons and SWD
TMC2209
Connectors

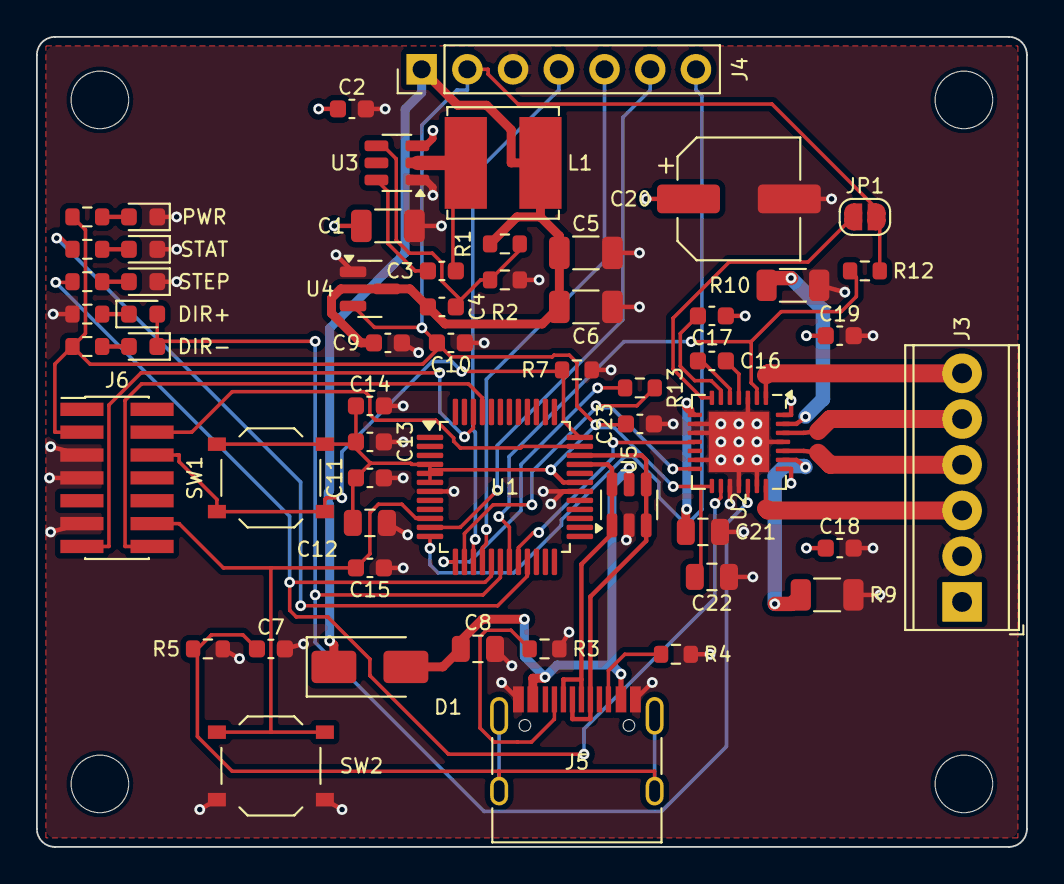
[picture p10: board ggsmdriver.kicad_pcb from above]

Board: 4 copper layers, 55.0 x 45.0 mm, 61 parts (0 on the bottom side), 45 nets.
