gustavgaston/ggsmdriver/(commit log)

2026-10-17 Ignore KiCad local history and .DS_Store
2026-10-17 Restore full .gitignore; untrack .DS_Store and KiCad local settings
    Claude-Session: https://claude.ai/code/session_01VFhb1Qv7mkaGrgvtw2CS4q
2026-10-17 firmware: STM32 HAL port of ggstepper core and the Automato bridge over USB CDC
    Builds with make (arm-none-eabi-gcc); CubeIDE project files included.
    Not yet run on hardware.
    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
2026-10-19 PCB: hand-laid TMC2209 power stage, no VREF trimmer, real track widths
    Motor outputs run 1 mm wide straight to J3 next to the chip (J3 now A2 A1 B1 B2),
    sense resistors and VS vias sit at the driver pins, VS caps join through a new
    In2.Cu VIN plane, as on the Adafruit breakout. VREF goes to GND since current is
    always set over UART. Netclass widths now reach the router. Fully routed, no DRC
    errors; fab files regenerated.
    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
    [ggsmdriver-bom.csv, ggsmdriver.kicad_pcb, ggsmdriver.kicad_sch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]
2026-10-19 PCB round 2: no barrel jack, power terminal beside motor terminal, stocked parts
    J1 removed; the VIN/GND terminal sits right below the motor terminal on the right
    edge. TMC2209-LA-T (C2150710), RALEC 50 mOhm 1206 sense resistors (C154645), red
    Basic / green LEDs replace out-of-stock parts. SPREAD pin reconnected (lost in the
    previous edit). Fully routed, no DRC errors; fab files regenerated.
    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
    [ggsmdriver-bom.csv, ggsmdriver.kicad_pcb, ggsmdriver.kicad_sch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]
2026-10-19 PCB: stocked 22 uF cap and three 2-pole terminals
    C20 is now Lelon VES220M1HTR-0605 (C176676). The out-of-stock 4-pole motor terminal is
    split into two KF350-3.5-2P blocks (J6 coil B, J3 coil A), so power and motor are three
    identical 2P blocks along the right edge. Coil B tracks, R10 and C19 moved to make room.
    Fully routed, no DRC errors; fab files regenerated.
    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
    [ggsmdriver-bom.csv, ggsmdriver.kicad_pcb, ggsmdriver.kicad_sch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]
2026-10-19 requirements: BOM table cap entry
    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
2026-10-20 PCB: one 6-pole 2.54 mm terminal for power and motor
    KF128-2.54-6P (C474924) replaces the three 3.5 mm 2-pole blocks, as on the Adafruit
    breakout. Motor tracks re-laid to the 2.54 mm pins. Fully routed, no DRC errors; fab files
    regenerated.
    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
    [ggsmdriver-bom.csv, ggsmdriver.kicad_pcb, ggsmdriver.kicad_sch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]
2026-10-20 PCB: hand-laid buck switch node and USB D+/D- pair
    U3 turned so its SW pin feeds L1 through a short 0.8 mm track. USB D+/D- run as one
    0.25/0.15 mm pair on F.Cu over the GND plane (about 90 ohm differential, estimated) through
    the USBLC6 flow-through pads, with a DRC rule file allowing the 0.15 mm gap between them.
    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
    [ggsmdriver.kicad_pcb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]
2026-10-20 Make all LEDs red (JLC Basic C2286)
    Fab files are regenerated in the follow-up Extended-part pass.
    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
2026-10-20 Swap Extended passives to JLC Basic, hand-solder the header
    C16 -> C21122, C17-19/C23 220nF -> 100nF C14663, C4 75pF -> 100pF C14858.
    J4 drops its LCSC number so it stays out of the JLC BOM/CPL. Board
    re-routed (0 unrouted, no DRC errors) and fab files regenerated.
    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
    [ggsmdriver-bom.csv, ggsmdriver.kicad_pcb, ggsmdriver.kicad_sch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]
2026-10-20 Ignore KiCad DRC/ERC reports (*.rpt)
    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
2026-10-20 LEDs in a labelled column at the top-right, re-routed
    D2-D6 stacked at x 49.9 with PWR/STAT/STEP/DIR+/DIR- silk labels; their
    resistors moved below J3. 0 unrouted, no DRC errors; fab regenerated.
    Docs record where the 75 pF and 220 nF values came from.
    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
    [ggsmdriver.kicad_pcb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]
2026-10-20 LEDs to the left side, C4 back to 75 pF, tidy silkscreen designators
    LED column now on the left with facing pads and hand tracks; designators
    placed by autopcb tidy_silk(). 0 unrouted, DRC clean; fab regenerated.
    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
    [ggsmdriver-bom.csv, ggsmdriver.kicad_pcb, ggsmdriver.kicad_sch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]
2026-10-21 Add STDC14 debug connector for the STLINK-V3MINIE
    J6 (Samtec FTSH-107-01-L-DV-K, hand-soldered) on the left under the LEDs:
    SWD, NRST, 3V3 sense, GND, and the probe's virtual COM on USART1 (PB6/PB7).
    SWD test pads removed. 0 unrouted, DRC clean; fab regenerated.
    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
    [ggsmdriver.kicad_pcb, ggsmdriver.kicad_sch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]
2026-10-21 Add aluminum case: top/bottom plate DXFs, assembled STL, parts list
    Claude-Session: https://claude.ai/code/session_0161Rc5EqzRoeoyTgRpJXrCb
    [ggsmdriver-case-bottom.dxf, ggsmdriver-case-top.dxf, ggsmdriver-case.stl]
2026-10-23 Replace aluminum case with slim 3D-printed snap-fit case
    Bottom cover flush with the board edge, M3 self-tapping bosses, two mounting
    holes; top cover snaps on, cable cutout for J3 and a thin slot for J4.
    Heights from the KiCad 10 3D models.
    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
    [ggsmdriver-case-bottom.dxf, ggsmdriver-case-bottom.step, ggsmdriver-case-bottom.stl, ggsmdriver-case-top.dxf, ggsmdriver-case-top.step, ggsmdriver-case-top.stl, ggsmdriver-case.step, ggsmdriver-case.stl]
2026-10-23 Case README: fix z offset for aligning with the KiCad STEP
    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
2026-10-23 Case: drop STL exports until the model is confirmed
    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
    [ggsmdriver-case-bottom.stl, ggsmdriver-case-top.stl]
2026-10-23 Case: Rhino model of the 3D-printed snap-fit case, STEP + print STLs
    [ggsmdriver-case-bottom-print.stl, ggsmdriver-case-bottom.step, ggsmdriver-case-top-print.stl, ggsmdriver-case-top.step, ggsmdriver-case.step, ggsmdriver_case.3dm]
